gaboprz/Taller_Integrador-Proyecto/Sprint 3/Sprint_3.pdf

# Avance 2, Proyecto de Taller Integrador

Hernandez Z ´ | arate Amanda, P ´ | erez Ram ´ | ´ırez Gabriel y Coto Alcazar Fransisco ´
Escuela de Ingenier´ıa Electronica, Tecnol ´ | ogico de Costa Rica, 30101 Cartago, Costa Rica, ´
{amanda.hz, gabo20021228, frjcotoa}@estudiantec.cr

Abstract—El presente informe corresponde a un avance del proyecto que busca generar una plataforma de interconexion´ que permita que el microcontrolador SIWA pueda funcionar. En este se muestran detalles del proceso de fabricacion y ´ de ensamblaje de la placa, ademas del proceso seguido para ´ programar la memoria que se usara para cargar programas en ´ el microcontrolador.
Keywords—SIWA, fabricacion, ensamblaje, memoria, SMD, ´ through hole
I. ESTRATEGIA DEL PROCESO DE FABRICACION´

El proceso de fabricacion del PCB para la plataforma de ´
interconexion del microcontrolador SIWA se desarroll ´ | o me- ´
diante una secuencia de etapas controladas que aseguraron la
calidad electrica y mec ´ | anica del circuito. Dentro de las cuales, ´
se describen brevemente las siguientes fases principales:

I-A. Drills

En esta etapa se realizo el perforado del sustrato de cobre ´ utilizando los archivos generados en Altium. En esta etapa se crearon los orificios necesarios para los componentes throughhole y las v´ıas de interconexion. ´

I-B. Metalizacion y Stencil ´

Posteriormente, la placa fue sometida a un proceso de metalizacion en seis etapas: limpieza y desengrase, acondi- ´
cionamiento, activacion de paredes, limpieza activa de v ´ | ´ıas,
galvanizado de cobre y estanado qu ˜ | ´ımico. Este procedimiento
permitio obtener una superficie conductora continua y adecua- ´ da para la soldadura posterior.

I-C. EndMill Bottom y Top

El trazado de las pistas se efectuo mediante el equipo LPKF ´ ProtoMat D104 en modo de fresado mecanico. Con el software ´ CircuitPro se eliminaron selectivamente las zonas de cobre no deseadas, definiendo las rutas conductoras. Se realizaron procesos de fresado tanto en la cara inferior (Bottom) como en la superior (Top) del PCB.

I-D. Verificacion Visual y de Cortos ´

Se efectuo una inspecci ´ | on visual completa para asegurar ´
la correcta formacion de las pistas y la ausencia de errores ´
de fabricacion. Adicionalmente, se comprob ´ | o la continuidad ´
de las trazas y el aislamiento entre nodos utilizando un mult´ımetro, descartando posibles cortos.

I-E. Recubrimiento con Estano˜

Una vez verificada la placa, se aplico un recubrimiento de ´ estano con el objetivo de mejorar la adherencia del material ˜ durante el proceso de soldadura y asegurar una buena conductividad de las uniones.

I-F. Soldermask y Silkscreen

Finalmente, se aplicaron las capas de soldermask y silkscreen. La primera proporciona proteccion mec ´ anica y define ´ las zonas de soldadura, mientras que la segunda incorpora la serigraf´ıa de componentes y referencias sobre la superficie del PCB.

II. ESTRATEGIA DEL PROCESO DE ENSAMBLAJE

El proceso de ensamblaje de la PCB se desarrollo en dos ´ etapas consecutivas, iniciando con la colocacion y soldadura ´ de los componentes SMD y continuando con la instalacion de ´ los conectores a traves de orificio (headers). ´
Para la fase SMD se empleo el equipo ´ | LPKF ProtoPlace
S. La colocacion se realiz ´ | o de forma asistida mediante la ´
herramienta de succion del sistema, que permiti ´ | o tomar cada ´
componente desde su presentador y posicionarlo sobre sus
pads. Con apoyo de la camara y la referencia de serigraf ´ | | ´ıa,
se alineo cada encapsulado hasta coincidir con las marcas ´
del diseno y, una vez verificada la orientaci ˜ | on, se ejecut ´ | o el ´
comando de place para depositarlo en su sitio. Concluida la
colocacion de los dispositivos peque ´ | nos (resistencias, capacito- ˜
res, reguladores y circuitos integrados discretos), se procedio´ a su soldadura conforme al procedimiento disponible en el
laboratorio. Al finalizar, se realizo una inspecci ´ | on visual para ´
comprobar alineacion y uniformidad del esta ´ | no en cada termi- ˜
nal, corrigiendo los casos en los que se detectaron soldaduras con exceso de material.
Completada la etapa SMD, se continuo con el montaje ´ de los conectores y headers. Esta fase se llevo a cabo ´ mediante soldadura manual con caut´ın, comenzando por el header principal de la tarjeta y siguiendo con los headers de
menor tamano, incluidos los destinados al m ˜ | odulo SIWA y ´
a la memoria Flash. Se cuido la verticalidad y el correcto ´ asentamiento de los conectores para garantizar el acoplamiento
posterior. Durante la soldadura se empleo esta ´ | no y se evit ˜ | o´
el sobrecalentamiento para no comprometer la integridad del laminado ni de los plasticos de los conectores. ´
Como control posterior, se realizo una revisi ´ | on r ´ | apida de ´
continuidad y aislamientos en puntos representativos, confirmando la ausencia de puentes y la presencia de contacto

electrico en las uniones cr ´ | ´ıticas. El ensamblaje quedo conclui- ´
do con todos los componentes SMD correctamente asentados y con los headers firmemente fijados y listos para las etapas de validacion el ´ ectrica y funcional. ´

III. PROGRAMACION DE LA MEMORIA ´

Luego de descargar e investigar un poco sobre el software
correspondiente a la programacion de la memoria, se identific ´ | o´
que el primer paso a realizar era el de instalar los drivers compatibles con la memoria en la laptop que se usa para programarla. Luego de esto, en el software se pueden abrir los archivos de programacion, y se pueden observar los valores en ´ las distintas direcciones de memoria. Al programar la memoria con un programa determinado, si los valores en las direcciones de memoria son iguales que los observados al leer el programa, se considera que la programacion fue existosa. ´

IV. RETROSPECTIVA DEL SPRINT 3
A lo largo de este sprint se utilizo la metodolog ´ | ´ıa de Agile
como forma de dividir las tareas y poder llevar un registro claro de lo que esta realizando cada integrante del grupo. En ´ este sprint implemento de manera satisfactoria, siendo esta y la ´ comunicacion constante la clave para completar los objetivos ´
planteados. Se logro estar presente en la mayor ´ | ´ıa de los d´ıas en
los que se estaba fabricando la PCB, al menos un participante, y los tres asistieron al ensamblaje, tanto de los componentes SMD y los Through Hole.
Se toma cada vez mas importancia de usar este tipo de ´
tecnicas y metodolog ´ | ´ıas para lograr sobrellevar proyectos en
lapsos de tiempo limitados.
V. CONCLUSIONES
La etapa de fabricacion concluy ´ | o con una placa sin cortos y ´
preparada para ensamblar los componentes correspondientes. La etapa de ensamblaje permitio colocar todos los compo- ´ nentes en la placa, soldandolos y asegurando la conectividad ´ en todos los nodos.
Ademas, se logr ´ | o programar la memoria con el programa ´
que estresa a los LEDs y el que estresa a la pantalla.

2
