gaboprz/Taller_Integrador-Proyecto/Sprint 1/Propuesta_grupo2.pdf

# Instituto Tecnológico de Costa Rica

# Taller Integrador

# Integrantes:

# Gabriel Pérez Ramírez

# Amanda Hernández Zárate

# Francisco Coto Alcázar

# Profesor: Renato Rímolo Donadio

# II Semestre 2025

# Partes_Proyecto_BOM

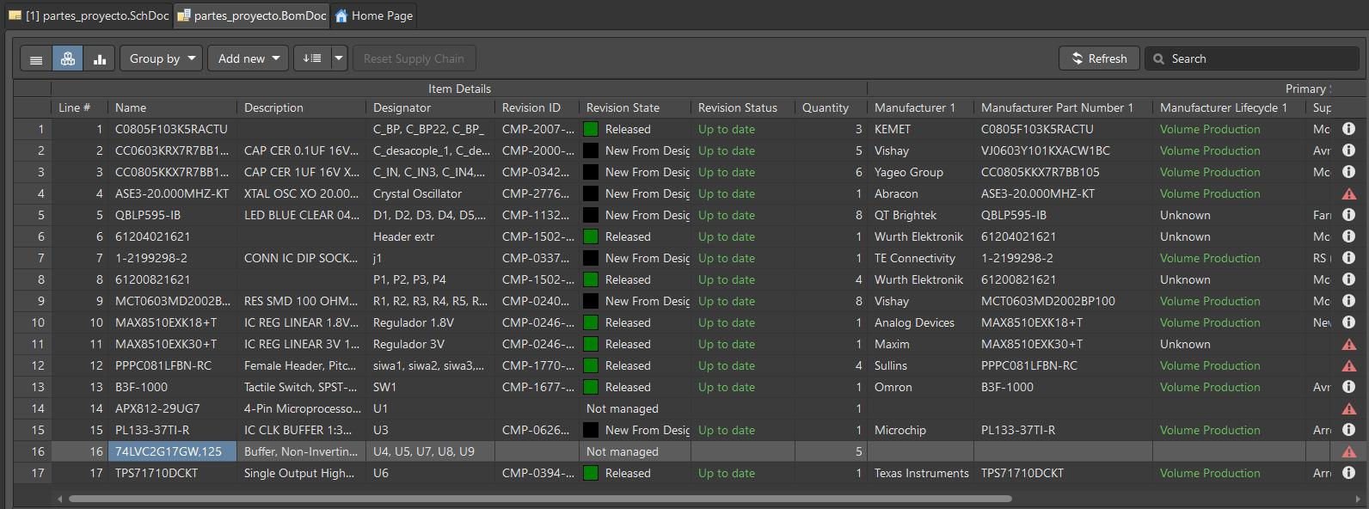
[picture p1: figure]
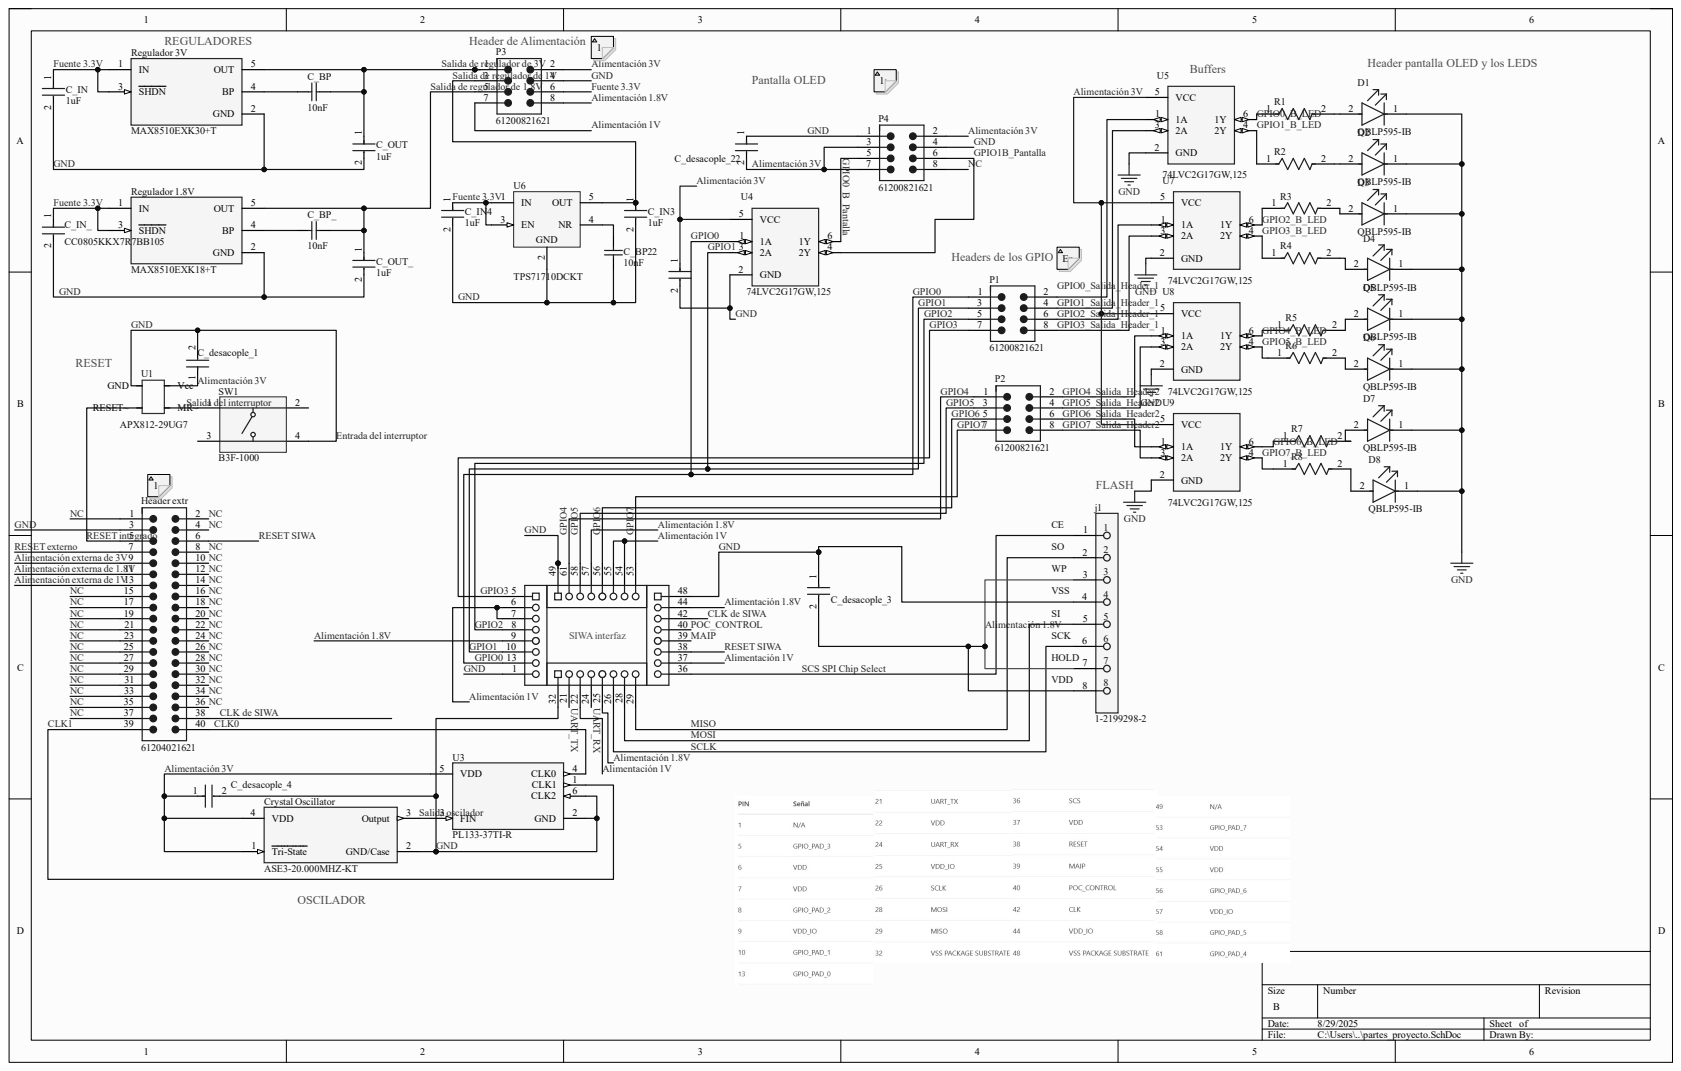
[picture p2: page 3]

Salida de regulador de 3V
Salida de regulador de 1V
Salida de regulador de 1.8V

Header pantalla OLED y los LEDS

Headers de los GPIO

SCS SPI Chip Select
