gaboprz/Taller_Integrador-Proyecto/Sprint 1/Link archivo de Burnout Chart.txt

Link archivo de Burnout Chart:
https://estudianteccr-my.sharepoint.com/:x:/g/personal/gabo20021228_estudiantec_cr/EQwFLzLfjUFImGyr0UsucwsBS_eCt2w51hJzkaoPuQnpZQ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
