gaboprz/Taller_Integrador-Proyecto/Sprint 4/Entregable/Burndown Chart.png

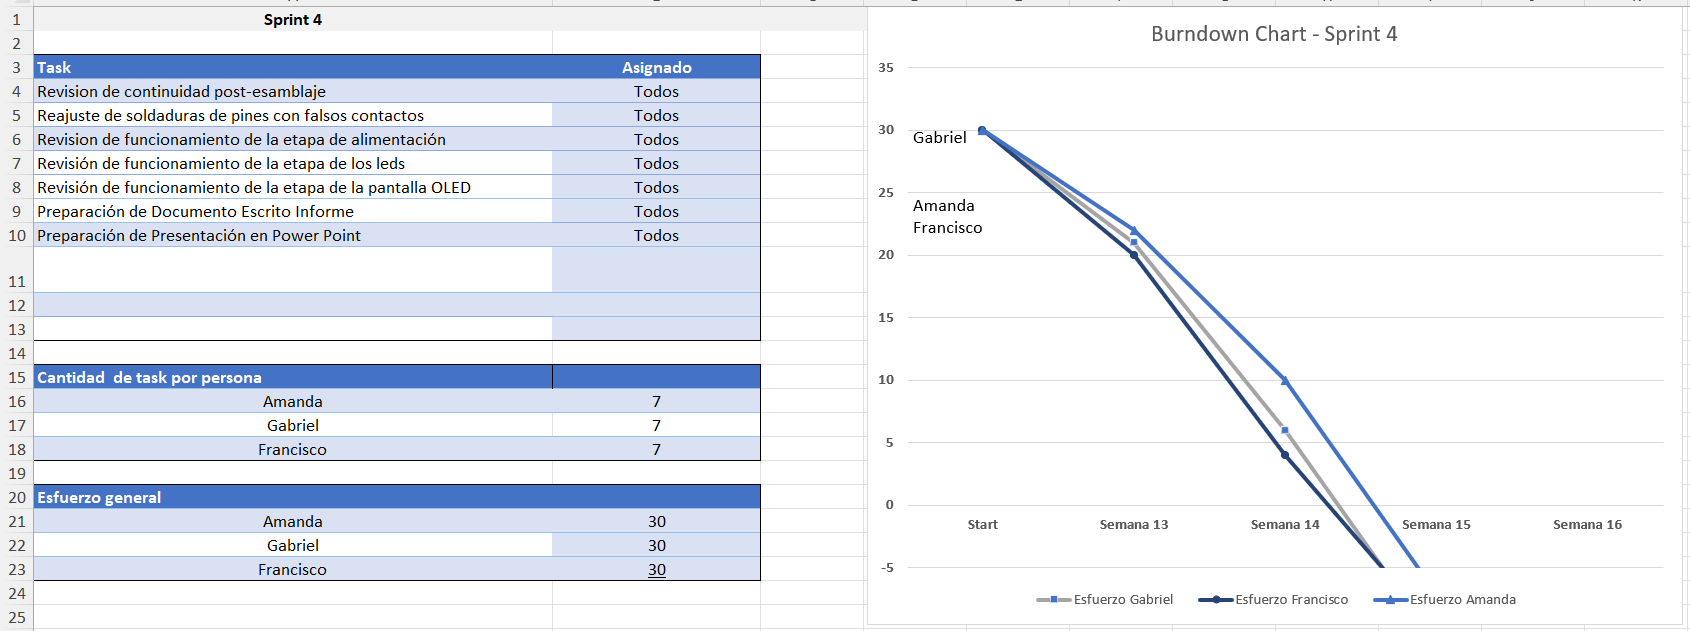
Sprint 4/Entregable/Burndown Chart.png
