gaboprz/Taller_Integrador-Proyecto/Sprint 4/Entregable/Git.png

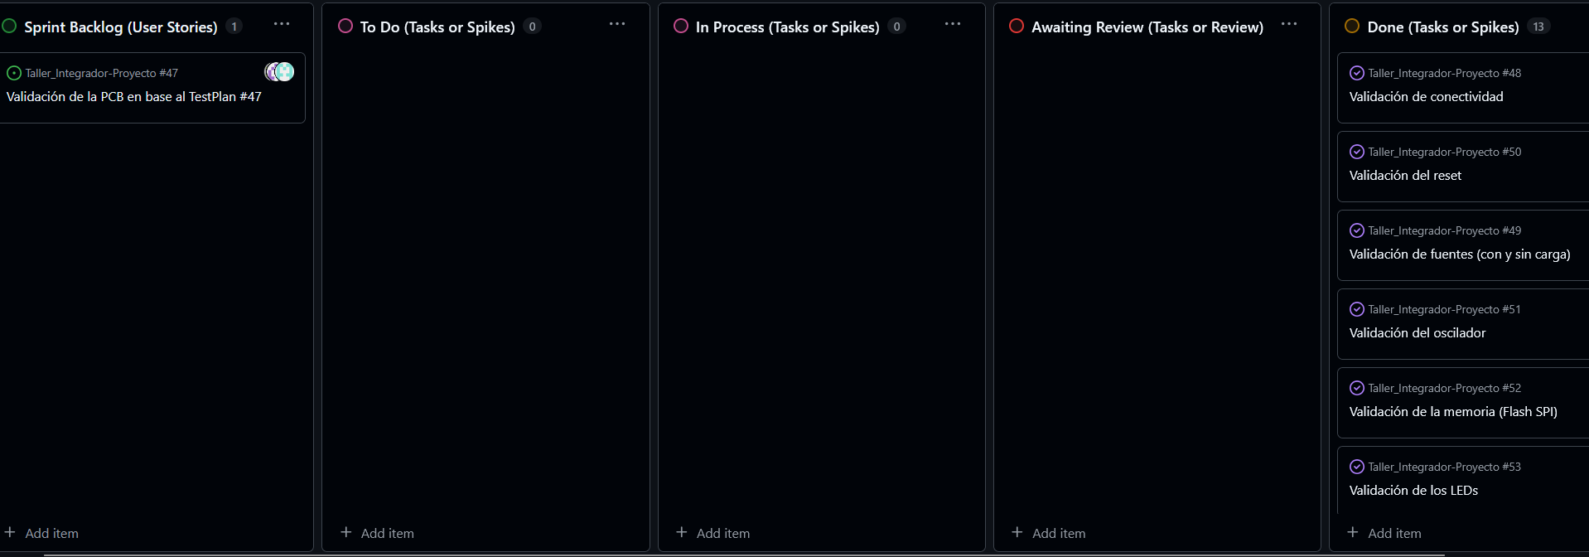
Sprint 4/Entregable/Git.png
