gaboprz/Taller_Integrador-Proyecto/Sprint 1/BoM.xlsx

Line # | Name | Description | Designator | Revision ID | Revision State | Revision Status | Quantity | Manufacturer 1 | Manufacturer Part Number 1 | Manufacturer Lifecycle 1 | Supplier 1 | Supplier Part Number 1 | Supplier Unit Price 1 | Supplier Subtotal 1
1 | C0805F103K5RACTU |  | C_BP, C_BP22, C_BP_ | CMP-2007-03708-1 | Released | Up to date | 3 | KEMET | C0805F103K5RACTU | Volume Production | Mouser | 80-C0805F103K5R | 0.3 | 0.9
3 | CC0805KKX7R7BB105 | CAP CER 1UF 16V X7R 0805 | C_des_1, C_des_2, C_des_3, C_des_4, C_des_5, C_des_6, C_des_7, C_des_8, C_des_9, C_des_10, C_IN, C_IN3, C_IN4, C_IN_, C_OUT, C_OUT_ | CMP-03422-000001-1 | New From Design | Up to date | 16 | Yageo Group | CC0805KKX7R7BB105 | Volume Production | Mouser | 603-CC805KKX7R7BB105 | 0.05 | 0.8
2 | CC0603KRX7R7BB104 | CAP CER 0.1UF 16V X7R 0603 | C_desacople_1, C_desacople_2, C_desacople_3, C_desacople_4, C_desacople_22 | CMP-2000-05002-2 | New From Design | Up to date | 5 | Vishay | VJ0603Y101KXACW1BC | Volume Production | Avnet | 62AC8337 | 0.036 | 0.18
4 | ASE3-20.000MHZ-KT | XTAL OSC XO 20.0000MHZ CMOS SMD | Crystal Oscillator | CMP-27762-010045-1 | New From Design | Up to date | 1 | Abracon | ASE3-20.000MHZ-KT | Volume Production
5 | QBLP595-IB | LED BLUE CLEAR 0402 SMD | D1, D2, D3, D4, D5, D6, D7, D8 | CMP-113271-000002-1 | New From Design | Up to date | 8 | QT Brightek | QBLP595-IB | Unknown | Farnell | 4469606 | 0.17828 | 1.78
6 | 61204021621 |  | Header extr | CMP-1502-00015-3 | Released | Up to date | 1 | Wurth Elektronik | 61204021621 | Unknown | Mouser | 710-61204021621 | 1.09 | 1.09
7 | 1-2199298-2 | CONN IC DIP SOCKET 8POS TIN | j1 | CMP-03370-000009-1 | New From Design | Up to date | 1 | TE Connectivity | 1-2199298-2 | Volume Production | RS (Formerly Allied Electronics) | 71373899 | 0.067 | 0.067
8 | 61200821621 |  | P1, P2, P3, P4 | CMP-1502-00006-2 | Released | Up to date | 4 | Wurth Elektronik | 61200821621 | Unknown | Mouser | 710-61200821621 | 0.97 | 3.88
9 | MCT0603MD2002BP100 | RES SMD 100 OHM 1% 1/8W 0603 | R1, R2, R3, R4, R5, R6, R7, R8 | CMP-02407-011165-1 | New From Design | Up to date | 8 | Vishay | MCT0603MD2002BP100 | Volume Production | Mouser | 594-MCT0603MD2002BP1 | 0.343 | 3.43
10 | MAX8510EXK18+T | IC REG LINEAR 1.8V 120MA SC70-5 | Regulador 1.8V | CMP-0246-00401-2 | Released | Up to date | 1 | Analog Devices | MAX8510EXK18+T | Volume Production | Newark | 73Y6124 | 0.225 | 0.225
11 | MAX8510EXK30+T | IC REG LINEAR 3V 120MA SC70-5 | Regulador 3V | CMP-0246-00520-2 | Released | Up to date | 1 | Maxim | MAX8510EXK30+T | Unknown
12 | PPPC081LFBN-RC | Female Header, Pitch 2.54 mm, 1 x 8 Position, Height 8.5 mm, Tail Length 3.2 mm, -40 to 105 degC, RoHS, Bulk | siwa1, siwa2, siwa3, siwa4 | CMP-1770-00002-1 | Released | Up to date | 4 | Sullins | PPPC081LFBN-RC | Volume Production
13 | B3F-1000 | Tactile Switch, SPST-NO, 0.05 A, 5 to 24 V, -25 to 70 degC, 4-Pin THD, RoHS, Bulk | SW1 | CMP-1677-00002-1 | Released | Up to date | 1 | Omron | B3F-1000 | Volume Production | Avnet | B3F1000 | 0.16998 | 0.16998
14 | APX812-29UG7 | 4-Pin Microprocessor Supervisor With Manual Reset. SOT143. | U1 |  | Not managed |  | 1
15 | PL133-37TI-R | IC CLK BUFFER 1:3 150MHZ 6SOT23 | U3 | CMP-06262-000018-1 | New From Design | Up to date | 1 | Microchip | PL133-37TI-R | Volume Production | Arrow Electronics | PL133-37TI-R | 2.49 | 2.49
 | 74LVC2G17GW,125 |  | U4, U5, U7, U8, U9 |  | Not managed |  | 5
17 | TPS71710DCKT | Single Output High PSRR LDO, 150 mA, Fixed 1 V Output, 2.5 to 6.5 V Input, with Low IQ, 5-pin SC70 (DCK), -40 to 85 degC, Green (RoHS & no Sb/Br) | U6 | CMP-0394-00843-2 | Released | Up to date | 1 | Texas Instruments | TPS71710DCKT | Volume Production | Arrow Electronics | TPS71710DCKT | 0.0897 | 0.0897
