gaboprz/Taller_Integrador-Proyecto/Sprint 3/TestPlan.pdf

II PLAN DE PRUEBAS | 1

# Test Plan para la verificacion del PCB para SIWA ´

Hernandez Z ´ | arate Amanda, P ´ | erez Ram ´ | írez Gabriel y Coto Alcazar Fransisco ´
Escuela de Ingeniería Electronica, Tecnol ´ | ogico de Costa Rica, 30101 Cartago, Costa Rica, ´
{amanda.hz, gabo20021228, frjcotoa}@estudiantec.cr
I. INTRODUCCION´

El presente documento muestra procedimientos, metodos y criterios necesarios para verificar el correcto funcionamiento del ´ prototipo desarrollado de la plataforma de interconexiones para el microcontrolador SIWA. Este documento describe las pruebas
electricas, funcionales y de seguridad que se aplicar ´ | an a la placa y a sus componentes asociados, con el fin de garantizar el ´
cumplimiento de los requerimientos de diseno. ˜
Las pruebas se realizaran siguiendo un enfoque sistem ´ | atico que permita detectar posibles fallos en la fabricaci ´ | on, el ´
ensamblaje o el desempeno del circuito. Asimismo, se documentar ˜ | an los resultados obtenidos y se establecer ´ | an los criterios ´
de aceptacion que aseguren que el producto final cumple con las especificaciones definidas durante la etapa de dise ´ | | no. ˜

II. PLAN DE PRUEBAS

II-A. Pruebas sin ASIC

II-A1. Validacion de conectividad ´
Esta verificacion busca comprobar que los distintos nodos que se plantearon en las simulaciones efectivamente est ´ | en´
conectados entre sí, ademas de comprobar que no hay nodos distintos en corto circuito. ´
Para realizar esto se toma la placa luego de las etapas de fabricacion de EndMill, con ayuda de un mult ´ | ímetro en modo
“Continuidad” y el PCB en la herramienta de Altium, se deben verificar que las conexiones entre nodos esten debidamente ´ conectadas o aisladas, segun sea el caso. ´
En caso de que existan dos nodos distintos en corto, se debe verificar de manera detallada las pistas de la placa, hasta
encontrar en donde se est ´ | as cortocircuitando dichos nodos (en d ´ | onde no se removi ´ | o el cobre de manera precisa). Con esto ´
identificado, se debe reenviar a la etapa de EndMill para corregir el error.
Esta metodología se debe repetir una vez ensamblados todos los componentes en la PCB, dado que al soldarse, estos podrían generar un corto entre nodos distintos. En caso de existir un corto, se debe inspeccionar la placa hasta determinar el componente que lo esta causando y corregir el problema. ´
En la Tabla I se puede observar las distintas verificaciones que se realizan para comprobar que la conectividad entre los distintos nodos de la placa es la esperada.
| | Tabla I
REVISION DE LA CONECTIVIDAD EN LOS DISTINTOS M ´ | ODULOS DE LA ´ | PCB.
Modulo ´ | Conectividad
Alimentacion´ | Esperada
SIWA | Esperada
LEDs | Esperada
Pantalla | Esperada
Memoria | Esperada
Header 40 pines | Esperada
Reset | Esperada
Reloj | Esperada

II-A2. Validacion de fuentes ´
Objetivo: verificar que los reguladores entregan el voltaje correcto y que la distribucion hacia la tarjeta es adecuada. ´ Header de 8 pines:
Izquierda: pin 1 = 3.0 V, pin 3 = 1.0 V, pin 5 = 1.8 V, pin 7 = entrada de 3.3 V.
Derecha: pin 2 = GND, pin 4 = Alimentacion 3 V, pin 6 = Alimentaci ´ | on 1 V, pin 8 = Alimentaci ´ | on 1.8 V. ´

II-A2a. 1) Prueba en vacío
Conectar la fuente externa: +3.3 V al pin 7 y GND al pin 2.
Medir con multímetro en modo DC cada rail respecto a GND (pin 2): primero en salida de regulador (1, 3, 5) y luego en distribucion´ (4, 6, 8).
Criterio: ±3 % del valor nominal. Diferencia entre salida y distribucion´ < 50 mV.

Cuadro II
FUENTES EN VACÍO (REGISTRO)
Medicion´ | Pines (+ → GND) | Valor esperado | Valor medido / OK
3.0 V (salida regulador) | 1 → 2 | 3.00 V ± 3 % | 3 V
3.0 V (distribucion) ´ | 4 → 2 | 3.00 V ± 3 % | 2.99 V
1.0 V (salida regulador) | 3 → 2 | 1.00 V ± 3 % | 1.01 V
1.0 V (distribucion) ´ | 6 → 2 | 1.00 V ± 3 % | 1.01 V
1.8 V (salida regulador) | 5 → 2 | 1.80 V ± 3 % | 1.79 V
1.8 V (distribucion) ´ | 8 → 2 | 1.80 V ± 3 % | 1.79 V

II-A2b. 2) Prueba bajo carga
Se simula consumo con una resistencia entre cada pin de distribucion y GND (pin 2). Se utiliza una corriente de prueba ´ aproximada de 20 mA. Las resistencias sugeridas se calculan con:

R =

V
I

, P =

V

2
R

Cuadro III
RESISTENCIAS DE CARGA SUGERIDAS (20 MA)
Rail (pin de distribucion) ´ | Resistencia | Potencia mín. | Conectar
3.0 V (pin 4) | 150 Ω | 0.06 W | 4 → 2
1.8 V (pin 8) | 90 Ω | 0.04 W | 8 → 2
1.0 V (pin 6) | 50 Ω | 0.02 W | 6 → 2

Pasos:
1. Con la placa energizada (7 = +3.3 V, 2 = GND), colocar una resistencia a la vez: 4→2, luego 8→2, luego 6→2.
2. Medir el voltaje en el mismo pin de distribucion respecto a GND (por ejemplo, 4 ´ | →2 con la resistencia conectada).

Cuadro IV
FUENTES BAJO CARGA (REGISTRO)
Rail | Pines (+ → GND) | Resistencia usada | Esperado | Medido / OK
3.0 V | 4 → 2 | 1k Ω | 3.00 V ± 3 % | 2.99
1.8 V | 8 → 2 | 1k Ω | 1.80 V ± 3 % | 1.004
1.0 V | 6 → 2 | 1k Ω | 1.00 V ± 3 % | 1.79

Criterios de aceptacion´
Cada rail dentro de ±3 % tanto en vacío como con la resistencia conectada.
Caída entre “salida” (1/3/5) y “distribucion” (4/6/8) ´ | < 50 mV.
Ausencia de calentamiento inusual en los reguladores durante la prueba.

II-A3. Validacion del reset ´
Se puede energizar la PCB y medir con multímetro el pin del RESET. Este debe estar en alto normalmente y, al presionar
el boton, debe caer a 0 V, provocando el reinicio del microcontrolador. Se debe asegurar que la se ´ | nal cambia correctamente y ˜
el microcontrolador se reinicia.
Al presionar el interruptor, se observa en el multimetro como el reset es normalmente en bajo, con un valor de 23.28 mV , y al presionarlo sube a 3.06 V .

II-A4. Validacion del oscilador ´
Esta verificacion busca comprobar que el circuito del oscilador bufferizado logra generar la se ´ | nal de reloj de manera correcta, ˜
es decir, con la frecuencia que se espera y que esta sea consistente.

Para comprobar esto, se va a energizar el modulo y con la ayuda de un osciloscopio se debe observar la se ´ | nal que el oscilador ˜
brinda en su salida. Luego de esto, hay que observar la salida ya bufferizada. En ambas se busca comprobar que esta posea
una frecuencia de 20 MHz, y que la amplitud entre las dos sea practicamente igual (idealmente el buffer tiene ganancia ´ | = 1).
En caso de no funcionar, se debe de conectar un reloj externo al pin 19 o al 21 del header de 40 pines del PCB. Con esto,
se procedería a observar en el osciloscopio la senal del reloj externo y se verificar ˜ | ía que esta posea la frecuencia de 20 MHz
que se espera.
Los detalles de las mediciones se muestran en la Tabla V.

Tabla V
REVISION DE LOS RELOJES EN LA ´ | PCB.
Senal ˜ | Amplitud | Frecuencia | Detalle
Reloj generado en la PCB | | | Para esta medicion se debe de colocar la ´ punta del osciloscopio en el pin 22 del header de 40 pines.
Reloj externo | | | Para esta medicion se debe de colocar la ´ punta del osciloscopio en el pin 19 del header de 40 pines.

II-A5. Validacion de la memoria (Flash SPI) ´
Objetivo: verificar alimentacion a 1.8 V, continuidad, niveles en reposo y capacidad de conducci ´ | on de las se ´ | nales SPI de la ˜
memoria Flash, sin utilizar modulos externos. ´
Header de 8 pines (segun serigraf ´ | ía):

Cuadro VI
PINOUT DEL HEADER DE MEMORIA
Pin | Senal ˜ | Descripcion´
1 | CS# | Chip Select (activo en bajo)
2 | MISO | Datos hacia el maestro
3 | VCC 1V8 | Alimentacion 1.8 V ´
4 | GND | Tierra
5 | MOSI | Datos desde el maestro
6 | SCLK | Reloj SPI
7 | VCC 1V8 | Alimentacion 1.8 V ´
8 | VCC 1V8 | Alimentacion 1.8 V ´

II-A5a. 1) Continuidad (sin energizar)
Verificar continuidad desde el header hacia el encapsulado de la Flash en CS#, SCLK, MOSI y MISO. Confirmar ausencia de cortos entre pines adyacentes del header.

Cuadro VII
CONTINUIDAD DE SENALES ˜ | SPI
Senal ˜ | Recorrido verificado | Resultado
CS# (pin 1) | Header → pin del IC
SCLK (pin 6) | Header → pin del IC
MOSI (pin 5) | Header → pin del IC
MISO (pin 2) | Header → pin del IC
Cortos adyacentes | Entre pines contiguos

II-A5b. 2) Alimentacion (placa energizada) ´ Aplicar 1.8 V a VCC (pines 3/7/8) y GND al pin 4. Medir VCC con multímetro en DC.

Cuadro VIII
VERIFICACION EL ´ | ECTRICA DE ´ | VCC Y GND
Medicion´ | Pines (+ → GND) | Esperado | Medido / OK
VCC 1.8 V | 3 → 4 | 1.80 V ± 3 % | 1.79
VCC 1.8 V | 7 → 4 | 1.80 V ± 3 % | 1.79
VCC 1.8 V | 8 → 4 | 1.80 V ± 3 % | 1.79

II-A5c. 3) Niveles en reposo (placa energizada, sin trafico SPI) ´
Medir con multímetro el nivel DC de CS#, SCLK, MOSI y MISO respecto a GND.
Criterio: coherencia con la polarizacion del dise ´ | no. Ejemplos t ˜ | ípicos: CS# en alto ≈ 1.8 V si existe pull-up; SCLK y
MOSI definidos por sus pulls; MISO en alta impedancia (nivel definido por pull si esta presente). ´

Cuadro IX
NIVELES EN REPOSO DE SENALES ˜ | SPI
Senal ˜ | Pin | Medido (V) | Criterio / Observacion´
CS# | 1 | Despreciable | Alto ≈ 1.8 V si hay pull-up
SCLK | 6 | | Alto/bajo segun pull ´
MOSI | 5 | | Alto/bajo segun pull ´
MISO | 2 | | Alta-Z; nivel segun pull (si existe) ´

II-A5d. 4) Ensayo de forzado suave (sin trafico SPI) ´
Con la placa energizada, aplicar una resistencia de 1 kΩ desde cada línea (CS#, SCLK, MOSI, MISO) a VCC (1.8 V) y luego a GND, una línea a la vez.
Medir el nivel resultante en el pin. Criterio: la línea debe seguir el forzado (cambiar de nivel) sin sobrecorriente ni caída anomala; indicio de que no hay cortos ni bloqueos en la ruta. ´

Cuadro X
FORZADO SUAVE CON 1 KΩ
Línea | Forzado | Pines | Voltaje medido | Observacion´
CS# | a VCC | 1 → 3 | | Debe subir cerca de 1.8 V
CS# | a GND | 1 → 4 | | Debe bajar cerca de 0 V
SCLK | a VCC | 6 → 3
SCLK | a GND | 6 → 4
MOSI | a VCC | 5 → 3
MOSI | a GND | 5 → 4
MISO | a VCC | 2 → 3
MISO | a GND | 2 → 4

Criterios de aceptacion´
VCC = 1.8 V dentro de ±3 % en los pines 3/7/8.
Continuidad correcta y sin cortos adyacentes en CS#, SCLK, MOSI y MISO.
Niveles en reposo coherentes con la polarizacion del dise ´ | no. ˜

II-A6. Validacion de los LEDs ´
Se puede cargar un firmware de prueba que encienda y apague los LEDs uno por uno. Se debe verificar visualmente que todos los LEDs funcionan correctamente. Opcionalmente, medir el voltaje o la corriente de cada LED.
| Cuadro XI
REGISTRO DE VERIFICACION DEL FUNCIONAMIENTO DE LOS ´ | LEDS
Grupo de GPIO | Pines (Header) | Comportamiento esperado | Observacion / OK ´
GPIO4–GPIO7 | SIWA U(2,3,5,8) | Parpadeo secuencial ≈ 2 Hz
GPIO0–GPIO3 | SIWA L(7,6,4,1) | Parpadeo secuencial ≈ 2 Hz

Se comprueba conectando con el reset a la entrada de los buffer, y que estos se encendían y apagaban al presionar el pulsador.

II-A7. Validacion de la pantalla ´
Esta verificacion busca comprobar que el m ´ | odulo de la pantalla OLED logra encenderse y comunicarse de manera correcta ´
mediante el protocolo SPI. Dado que para este punto aun no se tiene conectado el SIWA, hay que buscar otra forma de ´ comunicarse con la pantalla que se encuentra en la PCB.
Dado que no se encuentra el SIWA conectado, simplemente se va a realizar una verificacion similar a la de conectividad, ´ en la que se van a medir los voltajes que tienen los distintos pines del header de la pantalla, esto para verificar que tienen valores adecuados y no van a presentar un problema al conectar la pantalla. En la Tabla se pueden observar estos valores mas´ a detalle.

Tabla XII
REVISION DE VOLTAJES EN HEADER DE LA PANTALLA ´
Senal ˜ | Amplitud [V ] | Detalle
GND | | Se mide el pin 1 del header Screen con respecto a tierra.
Alimentacion´ 3 V | 3.01 V | Se mide el pin 2 del header Screen con respecto a tierra.
Alimentacion´ 3 V | 2.99 | Se mide el pin 3 del header Screen con respecto a tierra.
GND | | Se mide el pin 4 del header Screen con respecto a tierra.
GPIO 0 | | Se mide el pin 5 del header Screen con respecto a tierra.
GPIO 1 | | Se mide el pin 6 del header Screen con respecto a tierra.
Alimentacion´ 3 V | 2.98 | Se mide el pin 7 del header Screen con respecto a tierra.
GND | | Se mide el pin 8 del header Screen con respecto a tierra.

II-B. Pruebas con ASIC

II-B1. Validacion con SIWA y programa corriendo ´
Objetivo: verificar el arranque desde la memoria Flash y el funcionamiento basico del SIWA con firmware de prueba, ´ contemplando reset, reloj, actividad SPI y GPIO/LEDs, así como un registro simple de consumo.
Headers y pinout :

Cuadro XIII
RESUMEN DE HEADERS DE SIWA
Header | Pin | Senal / Nota ˜
SIWA U | 1 | GND
| 2 | GPIO4
| 3 | GPIO5
| 4 | Alimentacion 1.8 V ´
| 5 | GPIO6
| 6 | Alimentacion 1 V ´
| 7 | Alimentacion 1 V ´
| 8 | GPIO7
SIWA R | 1 | GND
| 2 | Alimentacion 1.8 V ´
| 3 | CLK de SIWA
| 4 | POC CONTROL
| 5 | MAIP
| 6 | RESET SIWA
| 7 | Alimentacion 1 V ´
| 8 | SCS (SPI Chip Select)
SIWA D | 1 | GND
| 2 | UART TX (no usado)
| 3 | Alimentacion 1 V ´
| 4 | UART RX (no usado)
| 5 | Alimentacion 1.8 V ´
| 6 | SCLK (SPI)
| 7 | MOSI (SPI)
| 8 | MISO (SPI)
SIWA L | 1 | GPIO3
| 2 | Alimentacion 1 V ´
| 3 | Alimentacion 1 V ´
| 4 | GPIO2
| 5 | Alimentacion 1.8 V ´
| 6 | GPIO1
| 7 | GPIO0
| 8 | GND

II-B1a. 1) Preparacion´
Cargar en la Flash un firmware de prueba que realice parpadeo secuencial de LEDs.
Instalar SIWA en el zocalo con orientaci ´ | on correcta; verificar continuidad de VCC/GND. ´

II-B1b. 2) Reset y reloj
Aplicar alimentacion nominal al sistema. ´
Verificar estado de RESET SIWA en reposo y pulso de reset manual. Medir la senal de ˜ CLK de SIWA.

Cuadro XIV
RESET Y RELOJ
Medicion´ | Punto / Puerto→GND | Esperado | Registrado / OK
RESET en reposo | SIWA R(6) → GND | Nivel alto valido (l ´ ogica 1) ´
Reset manual | SIWA R(6) → GND | Pulso valido y reinicio ´
CLK de SIWA | SIWA R(3) → GND | ≈ 20 MHz, estable

II-B1c. 3) Arranque desde Flash (actividad SPI)
Observar líneas SPI tras un reset: SCS (CS#), SCLK, MOSI, MISO.
Criterio: presencia de transacciones de lectura dentro de un tiempo breve posterior al reset; niveles 0–1.8 V y flancos definidos.

Cuadro XV
ACTIVIDAD SPI POST–RESET
Senal ˜ | Punto / Puerto→GND | Esperado | Observado / OK
CS# | SIWA R(8) → GND | Activo en bajo durante transaccion´
SCLK | SIWA D(6) → GND | Frecuencia y duty regulares
MOSI | SIWA D(7) → GND | Datos validos en el flanco correspondiente ´
MISO | SIWA D(8) → GND | Datos devueltos por la Flash

II-B1d. 4) Verificacion funcional (GPIO/LEDs) ´ Confirmar secuencia de LEDs en los GPIO indicados.

Cuadro XVI
GPIO/LEDS
Grupo | Puntos | Esperado | Registrado / OK
GPIO4–GPIO7 | SIWA U(2,3,5,8) | Parpadeo secuencial ≈ 2 Hz
GPIO0–GPIO3 | SIWA L(7,6,4,1) | Parpadeo secuencial ≈ 2 Hz

Criterios de aceptacion´
Arranque consistente tras reset; presencia de reloj estable.
Actividad SPI coherente posterior al reset (CS# activo, SCLK regular, MOSI/MISO con datos).
LEDs responden segun el firmware de prueba. ´
II-B2. Medicion de se ´ | nales ˜
Usar un multímetro u osciloscopio para comprobar: Voltajes de alimentacion ( ´ | VCC) dentro los rangos esperados. Presencia y
forma correcta de la senal de reloj. Con esto se puede verificar que todas las se ˜ | nales presentan niveles y frecuencias correctas. ˜

Cuadro XVII
VERIFICACION DE SE ´ | NALES EN LA ˜ | PCB CON SIWA
Senal ˜ | Punto de medicion (Header ´ → GND) | Valor esperado | Valor medido | Observacion / OK ´
VCC 1.0 V | Fuente interna / regulador | 1.00 V ± 3 %
VCC 1.8 V | Fuente interna / regulador | 1.80 V ± 3 %
VCC 3.0 V | Fuente interna / regulador | 3.00 V ± 3 %
Reloj (CLK SIWA) | SIWA R(3) → GND | 20 MHz ± 5 %
SCLK (SPI) | SIWA D(6) → GND | 0–1.8 V con flancos definidos
MOSI (SPI) | SIWA D(7) → GND | Datos validos en flanco de subida/bajada ´
MISO (SPI) | SIWA D(8) → GND | Datos devueltos por la Flash
RESET SIWA | SIWA R(6) → GND | Nivel alto en reposo, pulso bajo al reset

II-B3. Medicion de consumo ´
En esta verificacion se busca comprobar que el PCB posee niveles de consumo acorde a lo que se espera seg ´ | un la situaci ´ | on´
en la que se encuentre. Ya sea corriendo el programa que maneja los LEDs, el que maneja la OLED o simplemente está conectada, pero sin ejecutar nada.

Para esto, se va a conectar la alimentacion (la que alimenta los reguladores) y se van a monitorear los niveles de corriente ´
segun la situaci ´ | on en la que se encuentre el SIWA. ´
Los resultados detallados de estas mediciones se pueden observar en las Tablas XVIII, XIX, XX y XXI.

Tabla XVIII
MONITOREO DE LOS CONSUMOS DE LA FUENTE EXTERNA
Caso | Fuente externa [mA] | Descripcion´
Sin programa | | Se debe de conectar la GND de la fuente en el pin 2 del header Sources. Luego, se debe conectar el positivo de la fuente al amperímetro, cuya salida debe conectarse al pin 7 del header de Sources.

Programa de la pantalla

Programa de los LEDs

Tabla XIX
MONITOREO DE LOS CONSUMOS DE LA FUENTE DE 3 V
Caso | Fuente de 3 V [mA] | Descripcion´
Sin programa | | Se debe conectar el pin 1 del header Sources al positivo del amperímetro. Luego, se debe conectar el negativo al pin 4 del header de Sources.

Programa de la pantalla

Programa de los LEDs

Tabla XX
MONITOREO DE LOS CONSUMOS DE LA FUENTE DE 1.8 V
Caso | Fuente de 1.8 V [mA] | Descripcion´
Sin programa | | Se debe conectar el pin 5 del header Sources al positivo del amperímetro. Luego, se debe conectar el negativo al pin 8 del header de Sources.

Programa de la pantalla

Programa de los LEDs

Tabla XXI
MONITOREO DE LOS CONSUMOS DE LA FUENTE DE 1 V
Caso | Fuente de 1 V [mA] | Descripcion´
Sin programa | | Se debe conectar el pin 3 del header Sources al positivo del amperímetro. Luego, se debe conectar el negativo al pin 6 del header de Sources.

Programa de la pantalla

Programa de los LEDs
