gaboprz/Taller_Integrador-Proyecto/(threads)

Thread 29 (2025-09-02):

Preparar el archivo de PCB, asegurándose de que no hubieran errores con respecto a importar los componentes a este nuevo archivo

gaboprz, 2025-09-02:
Related to #28

##Esfuerzo estimado
2

Closed 2025-09-02.
