gaboprz/Taller_Integrador-Proyecto/Avance_1_Taller_Integrador.pdf

# Anvance 1. Proyecto de Taller Integrador

Amanda Hernandez Zarate ´

∗
, Gabriel Perez Ram ´ | ´ırez, Francisco Coto Alcazar ´
Escuela de Ingenier´ıa Electronica, Instituto Tecnol ´ | ogico de Costa Rica (ITCR), 30101 Cartago, Costa Rica, ´

Resumen—El presente corresponde a un avance del
diseno de una plataforma de interconexi ˜ | on y prueba para el ´
microcontrolador Siwa. En el cual se presenta el diseno del ˜
esquematico propuesto, el dise ´ | no del layout para el PCB, ˜
ademas de su estrategia de dise ´ | no y reporte de altium con ˜
las especificaciones.
Palabras Clave—Altium, Esquematico, Layout, Especifi- ´ caciones, Disenos, Stackup ˜
I. ESTRATEGIA DE ´ | DISENO˜ ESQUEMATICO ´

Para el esquematico, se comienza realizando el es- ´ tudio de los componentes requeridos segun la hoja de ´ especificaciones dada por el profesor. Se buscan las hojas de datos de cada componente, para asegurarse de que el numero de parte se encuentra dentro de la ´ herramienta de software Altium, ademas de cerciorarse ´
de que no necesita ningun tipo de interconexi ´ | on aparte ´
de su esquematico por defecto. ´
Luego, se investiga como deber ´ | ´ıan realizarse las cone-
xiones de los dispositivos, por ejemplo, se dimensionan los valores de las resistencias de proteccion de los leds ´
o como deber ´ | ´ıa conectarse el oscilador junto con su
buffer. En el caso del boton de reset, se utiliza un ´ esquematico creado desde cero en Altium, que cumpliera ´ con las dimensiones del footprint requerido, ya que el componente no se encontro en la herramienta. ´ Posteriormente, se hace la investigacion del uso de ´ cada pin del mico-controlador SIWA y sus correctas dimensiones para posteriormente colocar los headers correspondientes con las asignaciones correctas.
En cuanto a la estrategia de diseno en el esquem ˜ | atico, ´
se busco aprovechar bien el espacio, pero dado que era ´
un esquematico, no se deb ´ | ´ıa preocupar por las distancias
o por si hab´ıan cables entrelazados, entre otras cosas. Simplemente se coloca por etapas de forma que sirva de base para posteriormente comenzar a disenar el layout. ˜
El diseno del Esquem ˜ | atico puede ser visible en la ´
primera imagen adjunta al documento.
II. ESTRATEGIA DE ´ | DISENO PARA EL ˜ | LAYOUT DE
| LA PCB
El diseno pas ˜ | o por varias etapas de modificaci ´ | on, en ´
primera instancia se busca tomar como referencia el
diseno propuesto en el esquem ˜ | atico, esto con el fin de ´
determinar las dimensiones que iba a tener la tarjeta, la cual para este caso tiene una dimension de 120x100 mm ´ o bien 12x10 cm. Se considero que era espacio suficiente ´ para que tanto los componentes como los paths pudieran
ser colocados de la manera mas´ optima y as ´ | ´ı aprovechar
el espacio sin que todo este muy pegado y se complicara ´ el proceso de conexion. ´
Se definen las dimensiones del diseno, tomando en ˜ cuenta las especificaciones requeridas.
Mas adelante se adjunta el reporte de Altium, donde se puede apreciar el valor utilizado para el dielectrico en ´
este proyecto y ademas de los dem ´ | as valores imjportante ´
como el grosor de las capas y demas. ´
Con respecto a como se acomodo, se tomaron en ´ cuenta las sugerencias y posibles correcciones que se iban dando por parte del porfesor en cada una de las
sesiones de revision, el dise ´ | no final queda evidenciado ˜
mas adelante en las im ´ | agenes adjuntas al documento, ´
en donde se puede apreciar que el SIWA se encuentra en una posicion centralizada con los LEDS ubicados a ´ su izquierda en la parte superior y a la derecha en la parte inferior, esto con el fin de que los dispositivos de GPIO quedaran mas cerca del micro-controlador y ´ con esto se logra que los paths no recorran caminos
tan largos, ademas facilita la conexi ´ | on porque no se ven ´
interceptados con algunas otras senales de otros pines del ˜ SIWA. Los LEDS se conectan en grupos de 4 para hacer uso de los headers y que estos a su vez, sean conectados de forma ordenada al SIWA. La pantalla se coloca en el fondo para que f´ısicamente no se vea comprometido el espacio a la hora de colocarla, por culpa de algun header ´ del GPIO o por el propio SIWA.
En el caso de la memoria, se coloca en la esquina inferior derecha porque esta es externa y queda cercana a los pines correspondientes del SIWA y a demas a los ´ pines del Header 20x2 para el caso de conectar SPI de la memoria a este mismo.
El Header grande, al consumir mucho espacio y al ser utilizado por el Oscilador del CLK, la alimentacion y el ´
SIWA, se busca una posicion estrat ´ | egica en la que todos ´
estos tengan acceso a este. El cual se evidencia en la imagen correspondiente, que se encuentra en la esquina superior derecha junto con el reset y el oscilador, que no requiere mucho espacio.
Finalmente, la parte de la alimentacion se coloca en la ´ parte superior, porque as´ı puede haber suficiente espacio para sus reguladores y el header de alimentacion. Para ´ el caso de la alimentacion VCC se utiliza todo el Top ´ Layer, ya que todas las v´ıas son through hole y pueden conectarse a esta facilmente, lo mismo para conectarse a ´ GDN, la cual corresponde al Bottom Layer en donde se aterriza tanto los pines correspondientes de cada componente, como los pines que no estan conectados. ´

III. RETROSPECTIVA DEL SPRINT 2
El Sprint 2, el cual correspond´ıa al diseno del Layout ˜ del PCB, fue realizado en su mayor´ıa por los integrantes Amanda y Gabriel. Este diseno al principio se fue ˜ trabajando en conjunto, pero conforme se iba cambiando
el diseno y tomando en cuenta la retroalimentaci ˜ | on del ´
profesor, hab´ıa cada vez menos aporte o muestra de
interes del compa ´ | nero Francisco. ˜
Esto ya se converso como grupo y se har ´ | an las ´
correcciones necesarias para que no vuelva a suceder en las siguientes entregas o avances.
A manera de retrospectiva de lo que fue el Sprint, como grupo se considera que fue una experiencia reta-dora que requirio mucho tiempo y bastante cuidado pero ´ que fue bastante provechosa para aprender a utilizar la herramienta y en general en el diseno de PCBs. ˜

IV. CONCLUSIONES
El proceso de diseno del esquem ˜ | atico permiti ´ | o defi- ´
nir claramente la interconexion de los componentes ´ principales, garantizando que el microcontrolador
SIWA se encuentre en una posicion estrat ´ | egica para ´
optimizar la distribucion de se ´ | nales. ˜
Las decisiones tomadas en el diseno del layout ˜ de la PCB, como la centralizacion del SIWA y ´ la ubicacion de los LEDs y memorias, favorecen ´ recorridos mas cortos de las pistas y una mejor ´
organizacion de los headers, facilitando la conexi ´ | on´
y reduciendo posibles interferencias.
La definicion de par ´ | ametros t ´ | ecnicos como el espe- ´
sor del dielectrico y otros, asegura que el dise ´ | no˜
cumpla con buenas practicas de manufactura y ´ prepara el proyecto para las siguientes etapas de implementacion y pruebas. ´

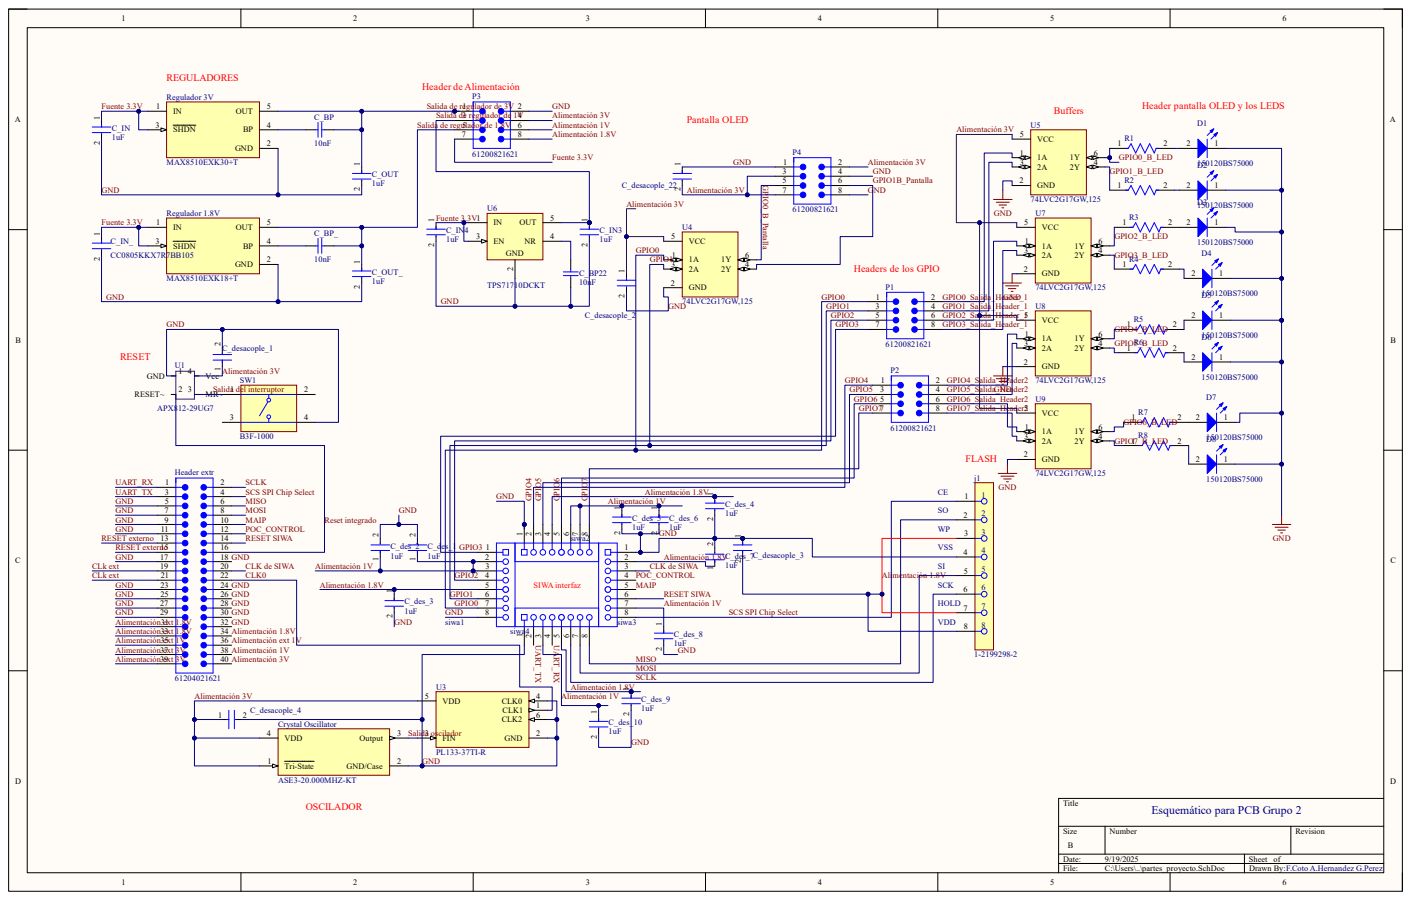
[picture p7: page 3]

Salida de regulador de 3V
Salida de regulador de 1V
Salida de regulador de 1.8V

Header pantalla OLED y los LEDS

Headers de los GPIO

SCLK
SCS SPI Chip Select

Esquemático para PCB Grupo 2

A

B

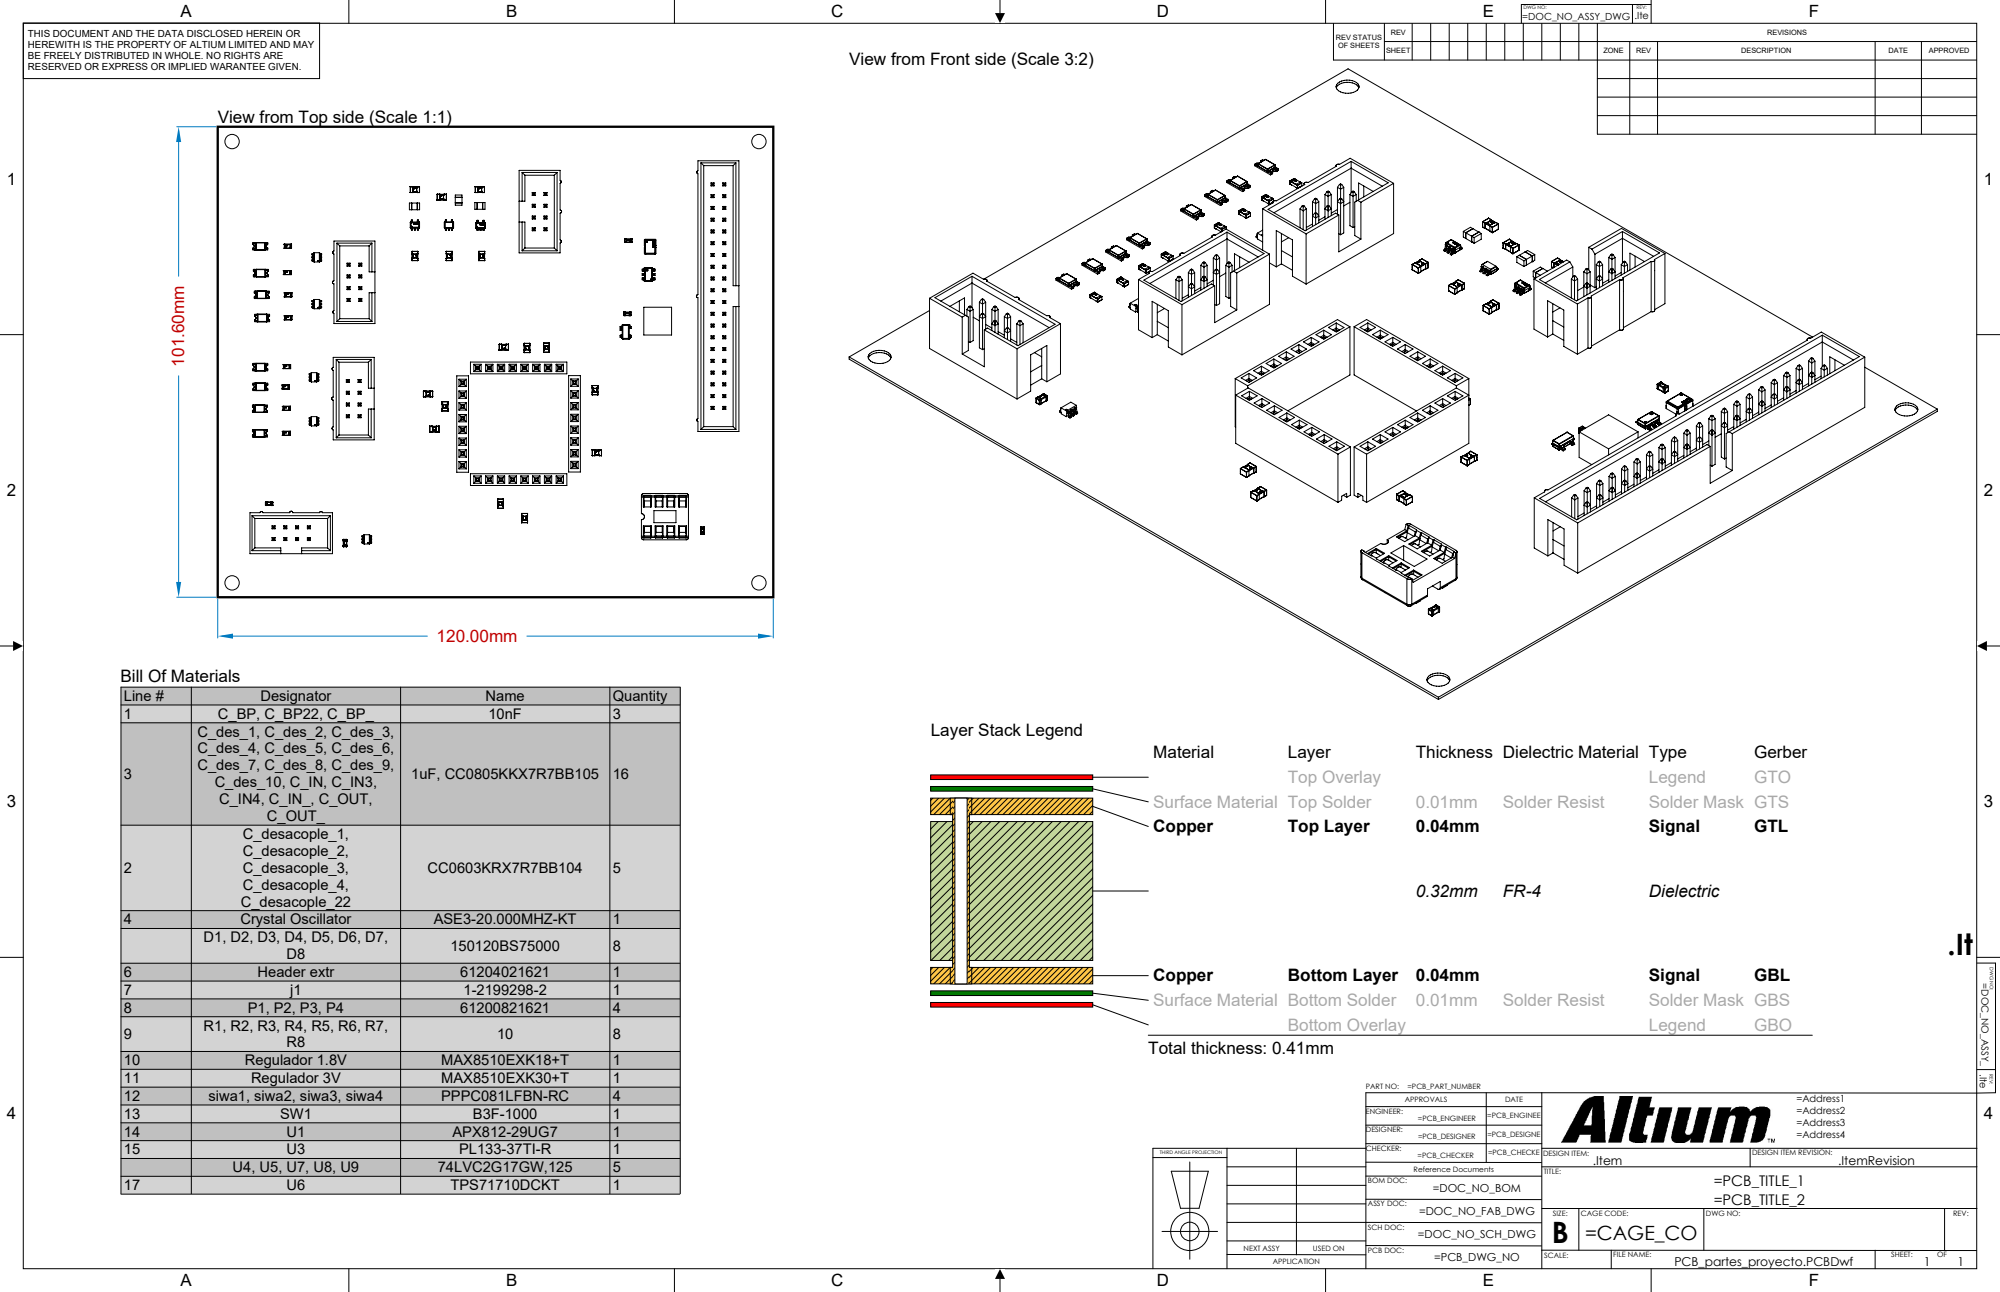
[picture p8: page 4]

HEREWITH IS THE PROPERTY OF ALTIUM LIMITED AND MAY
BE FREELY DISTRIBUTED IN WHOLE. NO RIGHTS ARE
RESERVED OR EXPRESS OR IMPLIED WARANTEE GIVEN.

View from Front side (Scale 3:2)

View from Top side (Scale 1:1)

Line # | Designator | Name | Quantity
1 | C_BP, C_BP22, C_BP_ | 10nF | 3
3 | C_des_1, C_des_2, C_des_3, C_des_4, C_des_5, C_des_6, C_des_7, C_des_8, C_des_9, C_des_10, C_IN, C_IN3, C_IN4, C_IN_, C_OUT, C_OUT_ | 1uF, CC0805KKX7R7BB105 | 16

2 | C_desacople_1, C_desacople_2, C_desacople_3, C_desacople_4, C_desacople_22 | CC0603KRX7R7BB104 | 5

4 | Crystal Oscillator | ASE3-20.000MHZ-KT | 1

6 | Header extr | 61204021621 | 1
7 | j1 | 1-2199298-2 | 1
8 | P1, P2, P3, P4 | 61200821621 | 4
9 | R1, R2, R3, R4, R5, R6, R7, R8 | 10 | 8

10 | Regulador 1.8V | MAX8510EXK18+T | 1
11 | Regulador 3V | MAX8510EXK30+T | 1
12 | siwa1, siwa2, siwa3, siwa4 | PPPC081LFBN-RC | 4

APPROVALS | DATE

THIRD ANGLE PROJECTION

U4, U5, U7, U8, U9 | 74LVC2G17GW,125 | 5

SCH DOC: =DOC_NO_SCH_DWG

NEXT ASSY | USED ON

A

B

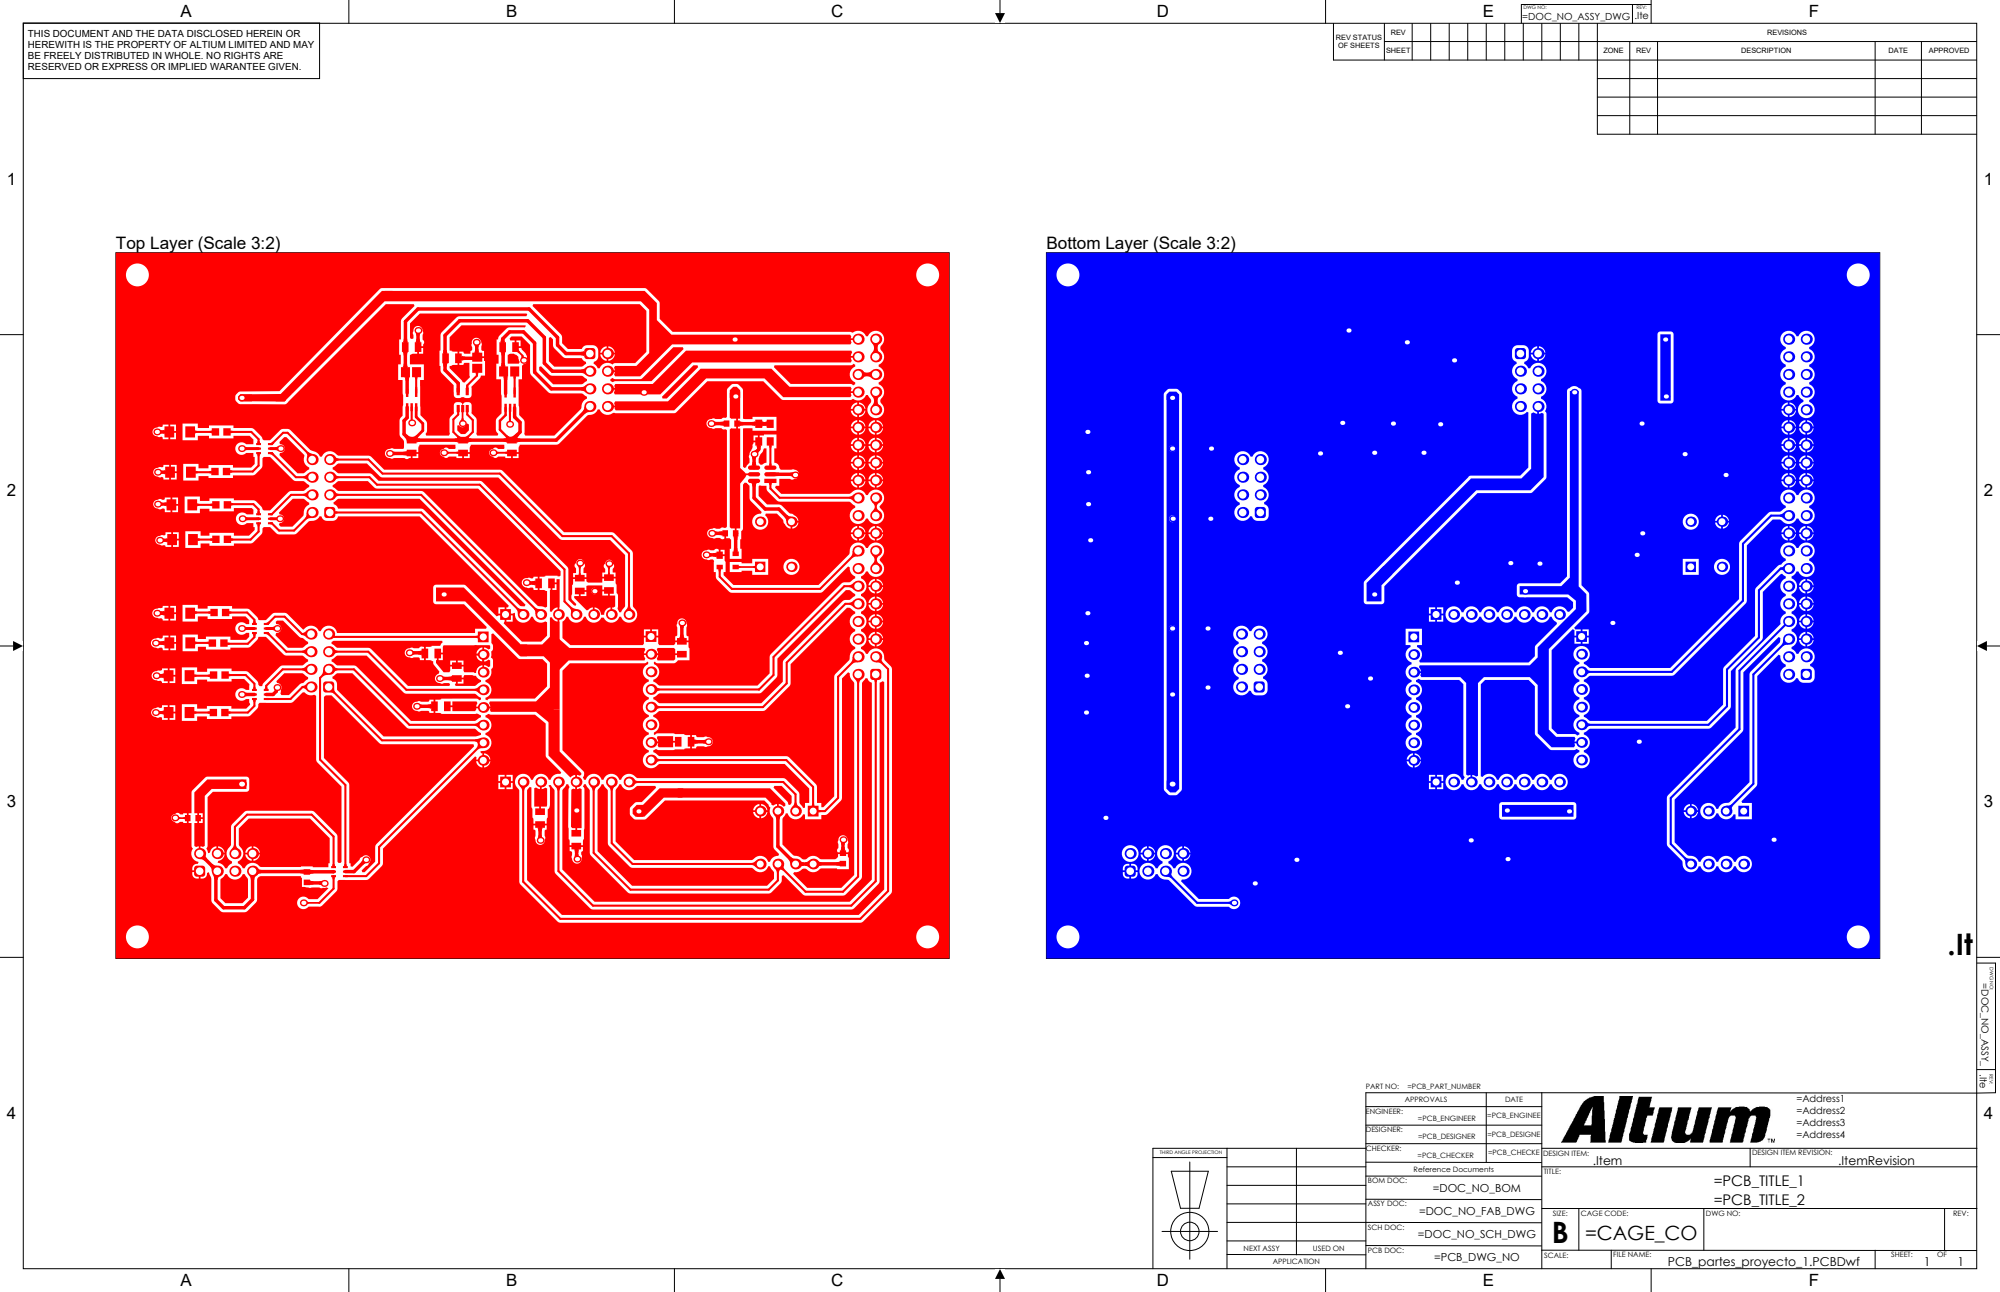
[picture p9: page 5]
Top Layer (Scale 3:2); Bottom Layer (Scale 3:2); SHEET:; SIZE:; CAGE CODE:; =Address1 =Address2 =Address3 =Address4; DWG NO:; REV:; =CAGE_CO; SCALE:; TITLE:; =PCB_TITLE_1 =PCB_TITLE_2; BOM DOC:; ASSY DOC:; PCB DOC:; =DOC_NO_BOM; Reference Documents; =DOC_NO_FAB_DWG; =PCB_DWG_NO; =DOC_NO_ASSY_; .Ite REV:; FILE NAME:; PCB_partes_proyecto_1.PCBDwf; DESIGN ITEM:; DESIGN ITEM REVISION:; .Item; .ItemRevision; ZONE; REV; DESCRIPTION; DATE; APPROVED; =DOC_NO_ASSY_DWG; .Ite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

APPROVALS | DATE

ENGINEER: =PCB_ENGINEER | =PCB_ENGINEE

DESIGNER: =PCB_DESIGNER | =PCB_DESIGNE

THIRD ANGLE PROJECTION

CHECKER: =PCB_CHECKER | =PCB_CHECKE

SCH DOC: =DOC_NO_SCH_DWG

NEXT ASSY | USED ON
