gaboprz/Taller_Integrador-Proyecto/(list of files, drawings)

Other design files:
partes_proyecto/Componentes_Importados/74LVC2G17GW_125/74LVC2G17GW,125.SchLib
partes_proyecto/Componentes_Importados/74LVC2G17GW_125/SOT363_INFINEON.PcbLib
partes_proyecto/partes_proyecto.PrjPcb
partes_proyecto/partes_proyecto.SchDoc
partes_proyecto/PCB_partes_proyecto.dsn
partes_proyecto/PCB_partes_proyecto.PcbDoc
partes_proyecto/PcbLib1.PcbLib
partes_proyecto/Schlib1.SchLib
