gaboprz/Taller_Integrador-Proyecto/partes_proyecto/Out/sizes.ini

[Page0.emf]
Pixel_PrintingWidth=4724
Pixel_PrintingHeight=4000
Mils_PrintingHeight=4000
Mils_PrintingWidth=4724
