gaboprz/Taller_Integrador-Proyecto/(commit log)

2025-08-08 Creación del repo y se añade un txt de prueba
2025-08-08 Se añade el excel del Gantt, este se encuentra en progreso
    [Gantt.xlsx]
2025-08-08 Se avanza el Gantt, falta añadir funcionalidad de las tareas bloqueadas
    [Gantt.xlsx]
2025-08-08 Se cambia el archivo de excel por un txt con el link del excel, esto para que editarlo sea más práctico
    [Gantt.xlsx]
2025-08-19 Prototipo de esquematico
    [PcbLib1.PcbLib, Schlib1.SchLib, partes_proyecto.PrjPcb, partes_proyecto.SchDoc]
2025-08-23 Se ajustan las etapas de alimentación, reset y se inicia la pantalla en el Altium
    [74LVC2G17GW,125.SchLib, SOT363_INFINEON.PcbLib, partes_proyecto.SchDoc]
2025-08-24 Etapa de interfaz SIWA y Memoria flash
    [partes_proyecto.SchDoc]
2025-08-25 Estableciendo conexion del oscilador y buffer en el esquematico principal
    [partes_proyecto.SchDoc]
2025-08-25 Agregando los leds indicadores bufferizados
    [partes_proyecto.SchDoc]
2025-08-27 Se ajustan detalles del proyecto
    [74LVC2G17GW,125.SchLib, PcbLib1.PcbLib, SOT363_INFINEON.PcbLib, Schlib1.SchLib, partes_proyecto.PrjPcb, partes_proyecto.SchDoc]
2025-08-27 Agregando conexion de LEDs y correccion de errores
    [partes_proyecto.SchDoc]
2025-08-28 Ajustes esquemático
    [partes_proyecto.SchDoc]
2025-08-28 conexiones finales
    [partes_proyecto.SchDoc]
2025-08-29 conexiones finales de todos los modulos
    [partes_proyecto.SchDoc]
2025-08-29 Se ajustan detalles finales para la entrega preliminar del esquemático y el archivo BOM
    [partes_proyecto.PrjPcb, partes_proyecto.SchDoc]
2025-08-29 Finalización Sprint 1
    [BoM.xlsx, partes_proyecto.PrjPcb, partes_proyecto.SchDoc]
2025-09-01 Se añade el Burnout Chart que se va a usar en el Sprint 2
2025-09-01 Avance en la preparación del PCB
    [partes_proyecto.PcbDoc, partes_proyecto.PrjPcb, partes_proyecto.SchDoc]
2025-09-01 Se prepara el archivo de PCB para comenzar a colocar los componentes y luego hacer las conexiones
    [PcbLib1.PcbLib, Schlib1.SchLib, partes_proyecto.PcbDoc, partes_proyecto.PrjPcb, partes_proyecto.SchDoc, partes_proyecto_.PcbDoc]
2025-09-02 Se realiza la primera iteración del PCB (disposición de los componentes) entre todos los integrantes del grupo
    [partes_proyecto.SchDoc, partes_proyecto_.PcbDoc]
2025-09-04 Se añaden capacitores de desacople al SIWA y se actualiza el excel con el archivo BoM
    [BoM.xlsx, partes_proyecto.SchDoc]
2025-09-06 Correcciones a PCB
    [PCB_partes_proyecto.PcbDoc, partes_proyecto.PrjPcb, partes_proyecto.SchDoc, partes_proyecto_.PcbDoc]
2025-09-08 Conexiones a PCB
    [PCB_partes_proyecto.PcbDoc, partes_proyecto.SchDoc]
2025-09-10 Mejoras PCB
    [PCB_partes_proyecto.PcbDoc, partes_proyecto.SchDoc]
2025-09-12 Nueva iteración del arreglo del PCB
    [BoM.xlsx, PCB_partes_proyecto.PcbDoc, partes_proyecto.PrjPcb]
2025-09-17 Agregando GND al PCB
    [PCB_partes_proyecto.PcbDoc]
2025-09-17 Se ajustan conexiones del PCB, mas se indica que a este se le deben hacer cambios importantes
2025-09-18 PCB renovado
    [partes_proyecto.PrjPcb, partes_proyecto.SchDoc]
2025-09-19 PCB super renovado
    [partes_proyecto.SchDoc]
2025-09-19 Se ajusta el clearence, se revisan las conexiones realizadas y se agregan los label de los componentes
    [partes_proyecto.PrjPcb, partes_proyecto.SchDoc]
2025-09-19 Se arreglan los pads del PCB
2025-09-19 Ajustando distancias del SIWA
    [PCB_partes_proyecto.dsn]
2025-09-20 Ajustando los nombres de la tarjeta y nombre del TEC
2025-09-20 PCB correccion de lineas
2025-09-20 PCB teardrops
2025-09-21 Ajustes de nombres en top overlay, además de revisión y ajustes menores del PCB en general
2025-09-21 PCB arreglo de lineas
2025-10-01 Se ajustan los clearences
    [partes_proyecto.PrjPcb]
2025-10-02 Se crea regla del Tented de las vías en el PCB
2025-10-03 Cambiando el modelo de los capacitores de 1uF
    [partes_proyecto.SchDoc]
2025-10-04 Corecciones finales
    [PCB_partes_proyecto.PcbDoc]
2025-10-07 Se arreglan errores indicados por Natalia
    [PCB_partes_proyecto.PcbDoc]
2025-10-08 Se suben los archivos para programar la memoria
2025-10-15 Se archivos de pdf, la propuesta del testplan y la bitácora de fabricación y ensamblaje
2025-10-21 Se actualiza el pdf de la bitácora de fabricación
